Toneto17/Estribera-de-Trial/figures/fig_03_condiciones_contorno.png

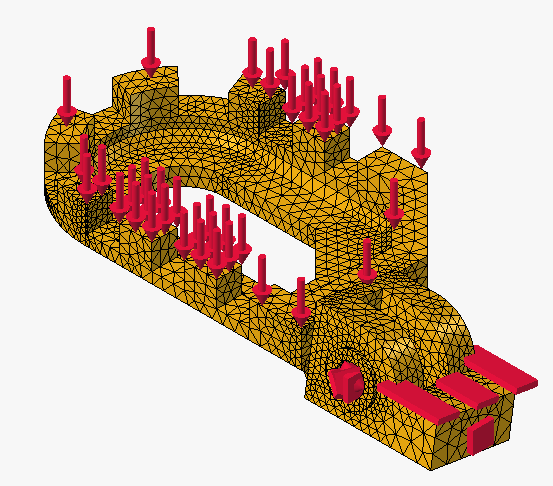
figures/fig_03_condiciones_contorno.png
