Toneto17/Estribera-de-Trial/figures/fig_07_von_mises_caso1.png

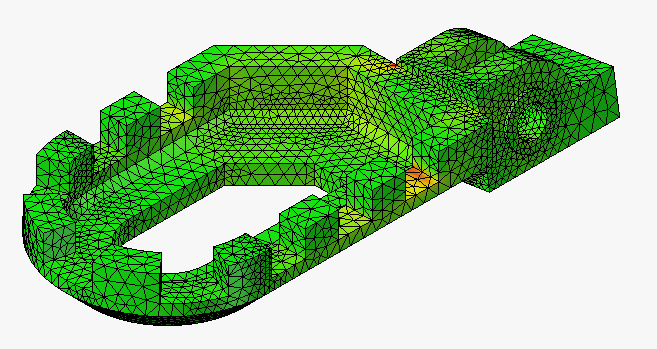
figures/fig_07_von_mises_caso1.png
