Toneto17/Estribera-de-Trial/figures/fig_09_deformacion_caso1.png

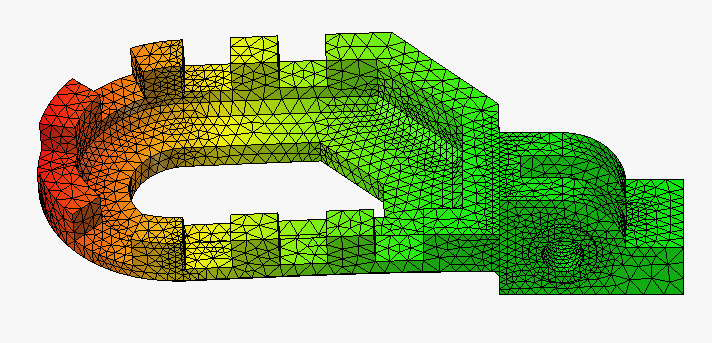
figures/fig_09_deformacion_caso1.png
