Toneto17/Estribera-de-Trial/figures/fig_ml_scatter_features_targets.png

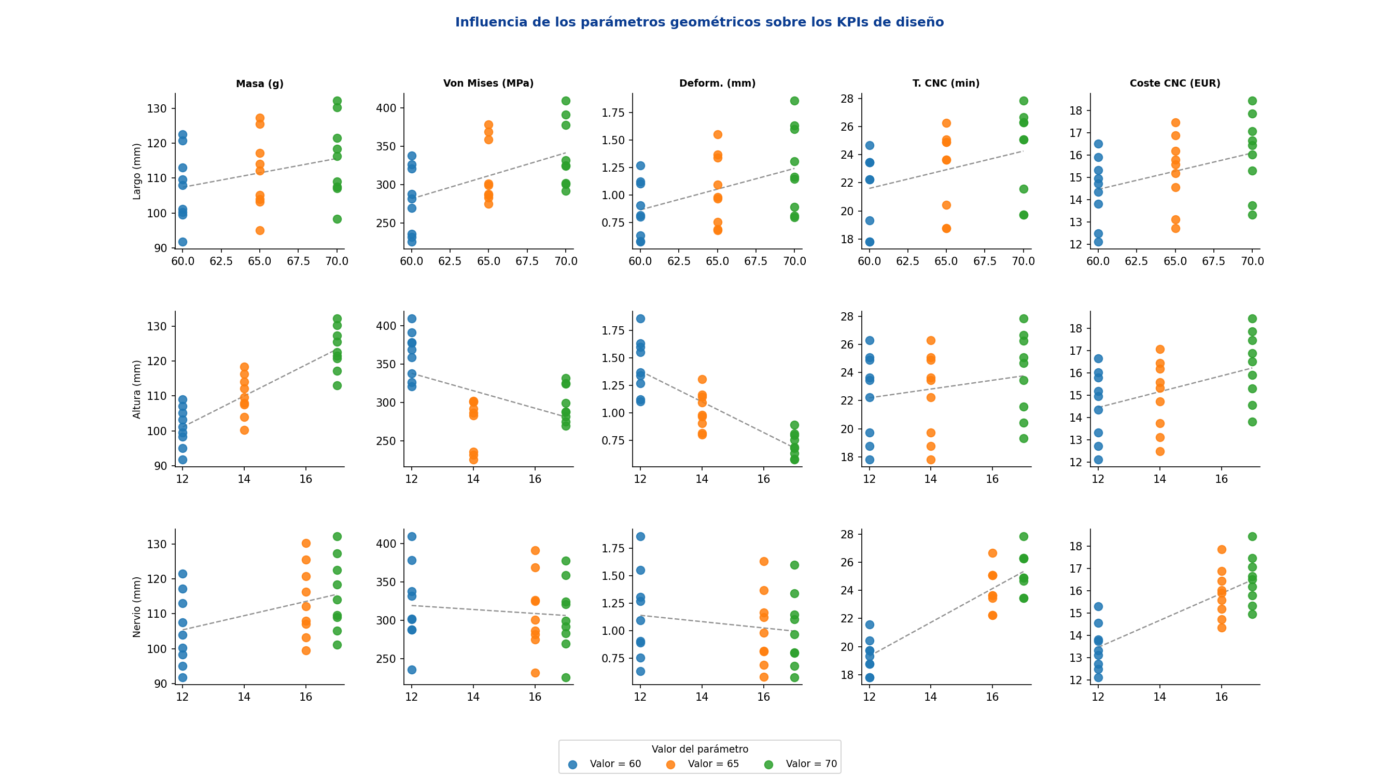
figures/fig_ml_scatter_features_targets.png
