Toneto17/Estribera-de-Trial/Estribera_Trial_V3_ID01.stl

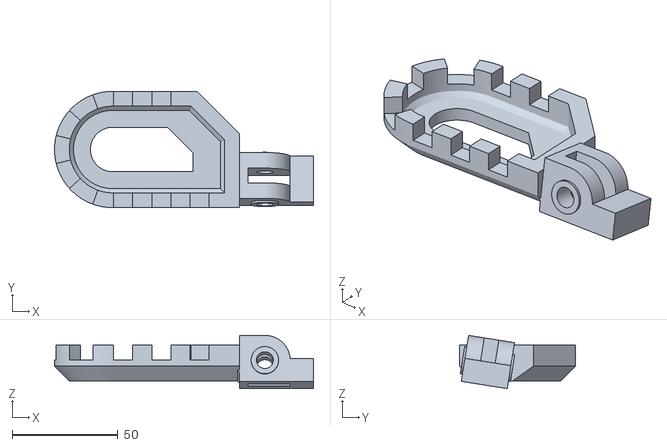
[picture p23: CAD file, 2026-04-23]
Estribera_Trial_V3_ID01.stl
122.5 x 55.0 x 25.2
