Toneto17/Estribera-de-Trial/Estribera_Trial_V3_Página_DN_AAA.pdf

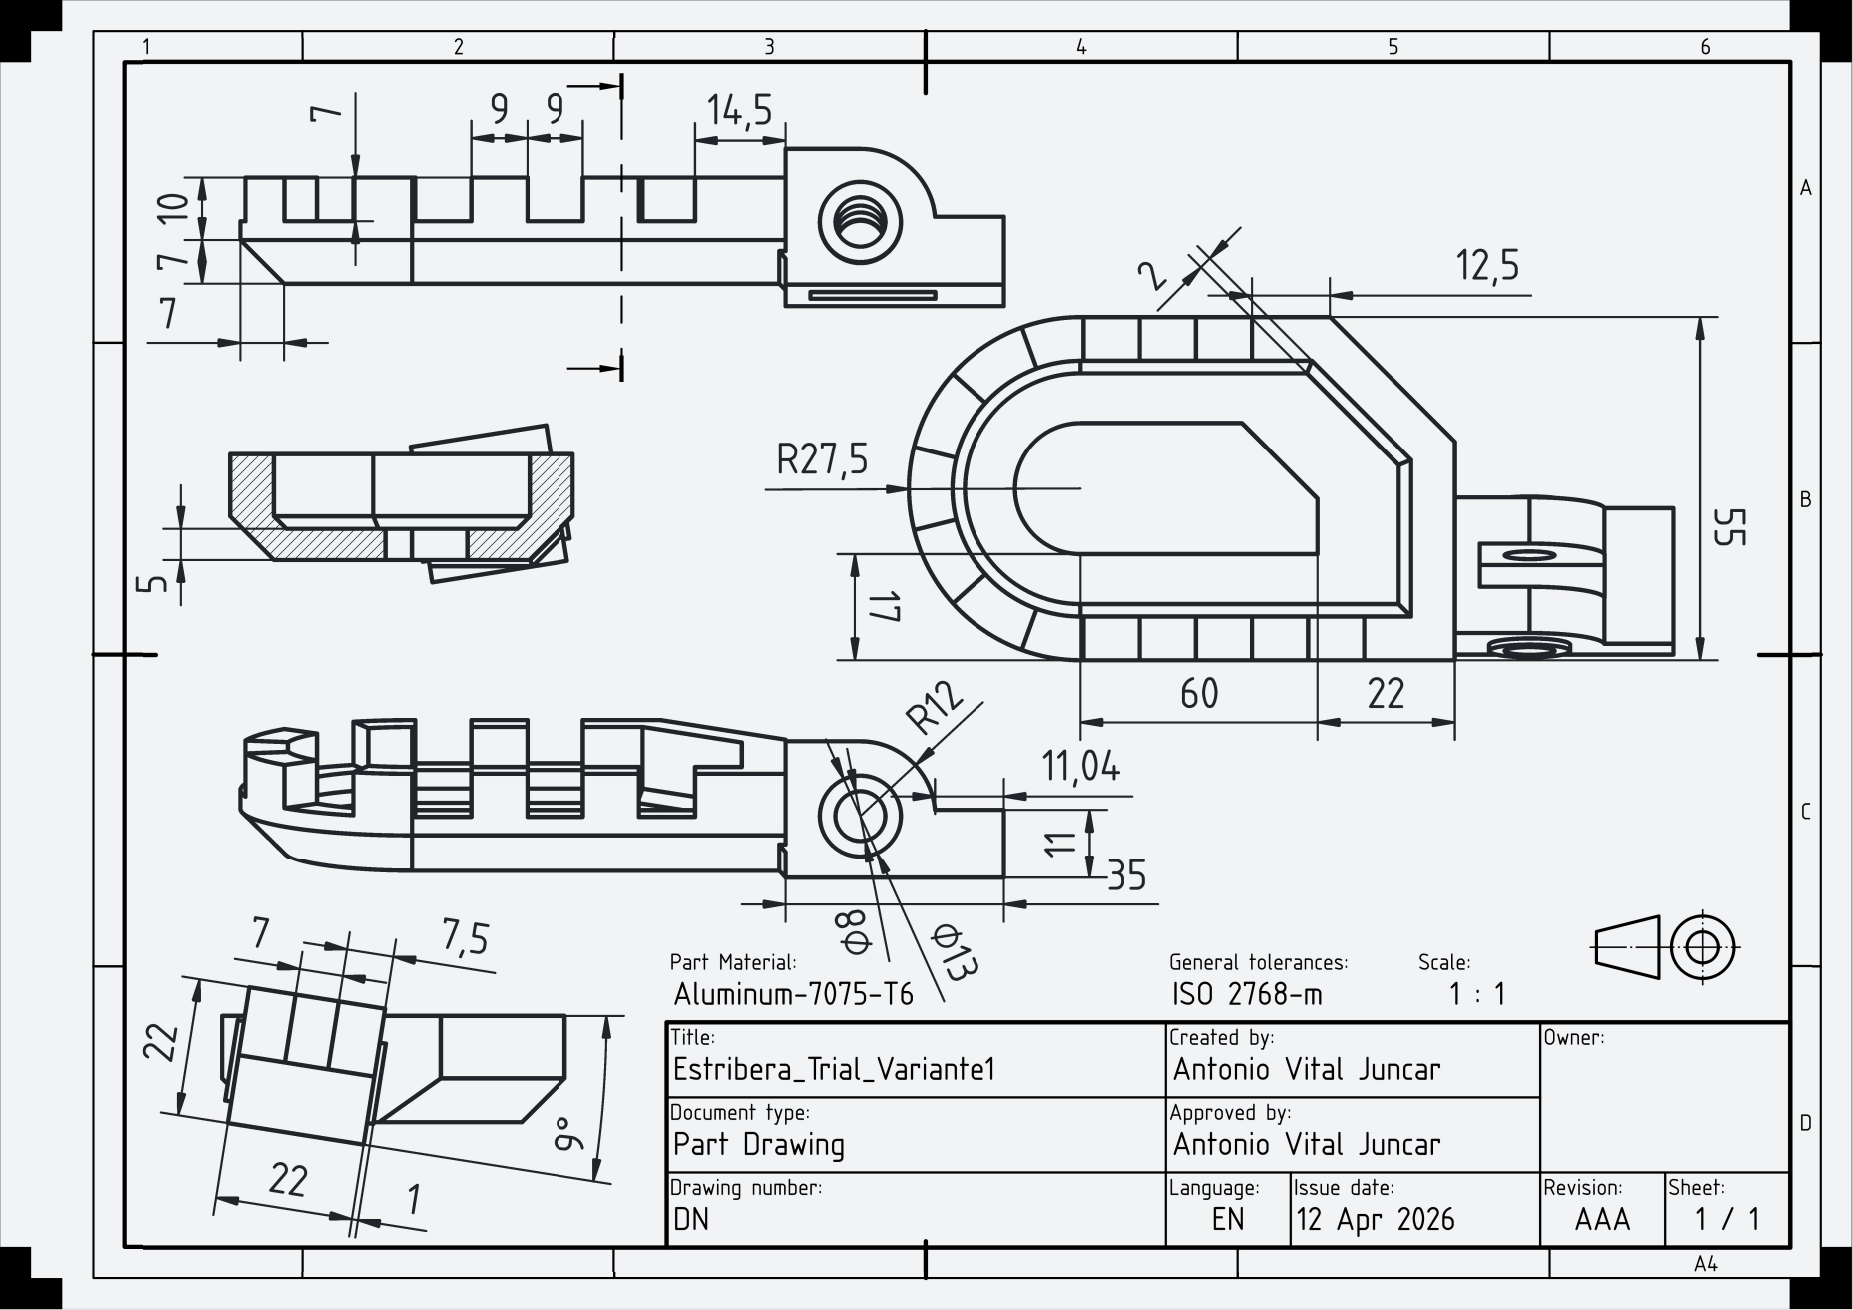
[picture p24: page 1]
