Toneto17/Estribera-de-Trial/(commit log)

2026-04-23 Proyecto completo: Estudio CAD, CAM, FEM y ML de una estribera de trial
    [Dataset_Train_Estribera.xlsx, Estribera_Trial_V3_ID01.stl]
2026-04-24 Añadir foto real S3 Hard Rock: portada dual y nueva sección de referencia
    - Portada: render CAD y foto real de la estribera S3 Hard Rock lado a lado
    - Nueva subsección 2.2: descripción técnica de la estribera de referencia
    con características (material, dientes, fijación, peso, precio de mercado)
    y justificación de su uso como punto de partida del diseño
